CursedPrograms/WHIP-Robot-v00/images/whip_real_round.png

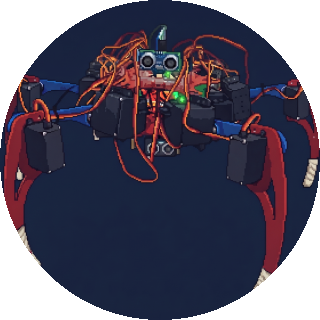
images/whip_real_round.png
