CursedPrograms/WHIP-Robot-v00/6 legged spider robot assembly manual.pdf

# 6 Assembly Instructions for the Spider Robot

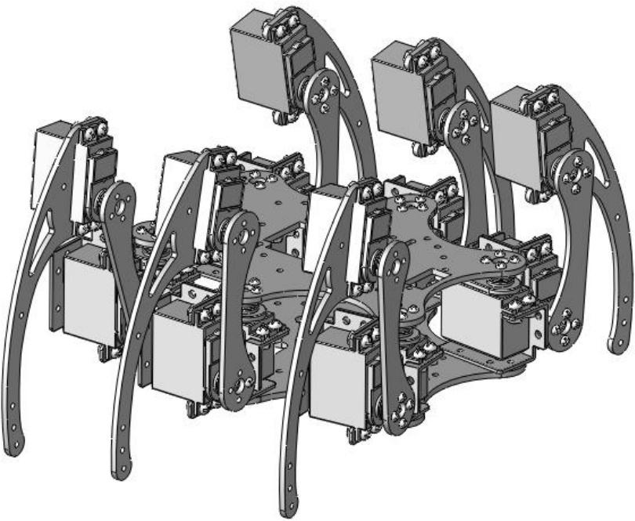
[picture p16: figure]

Preface

1.Installation Tools
Before installing the robot, it is necessary to prepare the necessary installation tools, including a crosshead screwdriver, a pair of pointed pliers, and a pair of forceps. Users with the conditions can prepare an electric screwdriver, which is both convenient and efficient, as shown in the reference image below.

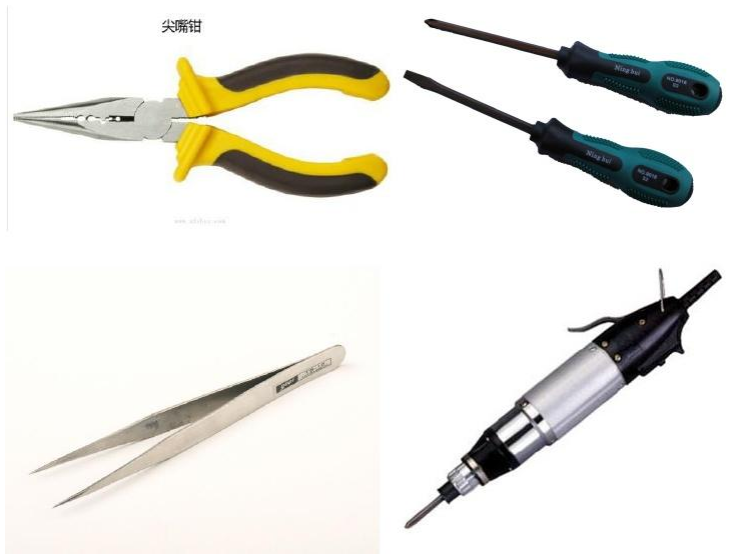
[picture p17: figure]

2. Usage Precautions
(1) There is a large enough platform space for the
installation of robots;
(2) During the operation, prevent mechanical damage and keep away from infants and young children. If left unattended, improper operation may cause harm to people. (3) The wiring and debugging of electronic accessories require

personnel with certain electronic knowledge and foundation to operate. It is prohibited to connect the wires without understanding the situation, as it is prone to causing short circuits or burns of the accessories. (4) Disassembling the battery is prohibited. When the robot

malfunctions, please cut off the power supply in time. battery

During use, recharge frequently and avoid excessive discharging. Do not short-circuit the positive and negative electrodes of the battery. The consequence of short-circuiting is very serious. Do not allow young children to charge, discharge or use the battery alone

(5) During the use of the robot, be careful to handle it gently and avoid throwing or hitting it. Also, take measures to prevent the robot from frequently falling, as this can easily cause structural deformation of the robot, thereby leading to abnormal operation.
I. Connection and Installation between Metal Structural Components
1. Installation of the right leg joint bracket
Quantity: Install 3 sets
Requirement: Install vertically without tilt. Accessories: Round head M3*6 screws, M3 nuts

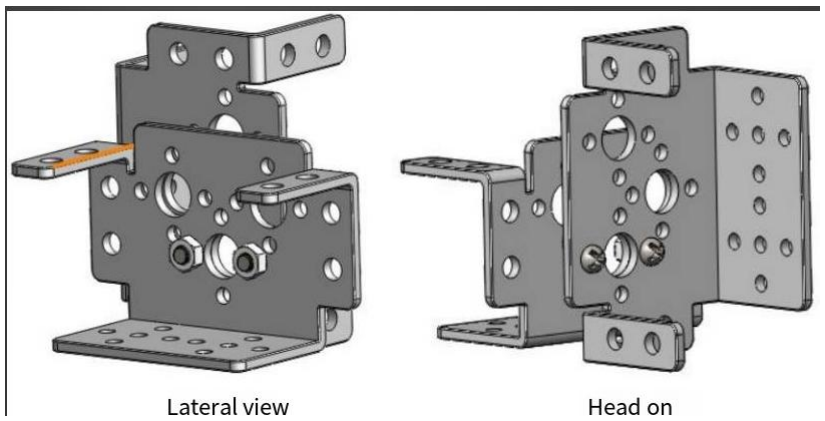
[picture p18: figure]

2. Installation of the left leg joint bracket Quantity: Install 3 sets
Requirement: Install vertically without tilt. Accessories: Round head M3*7 screws, M3 nut

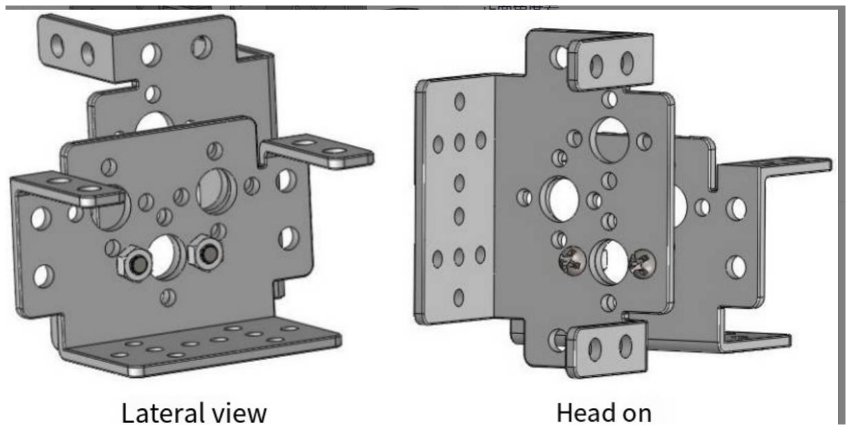
[picture p19: figure]

### II. Installation and Fixation of Each Component's Steering Gear

All the steering gear angles should be adjusted to the median position of 1500. The steering gear should be installed vertically and horizontally when installing the steering wheel. 1. Installation and fixation of the right calf bracket and

steering gear
Quantity: Install 3 sets
Requirement: Install vertically without tilt. Accessories: Round head M4*8 screws, M4 nuts

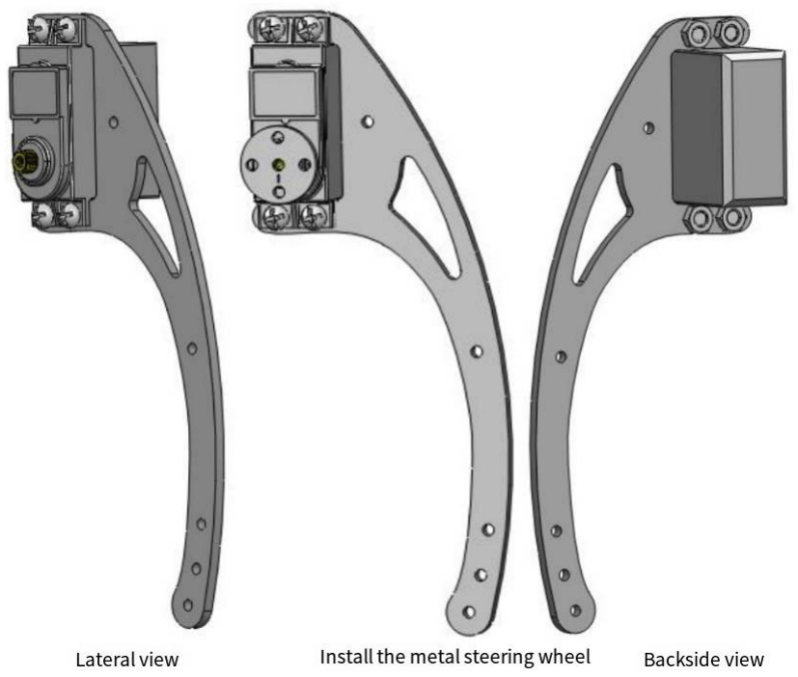
[picture p20: figure]

2. Installation and fixation of the left calf bracket and steering gear
Quantity: Install 3 sets
Requirement: Install vertically without tilt. Accessories: Round head M4*8 screws, M4 nuts

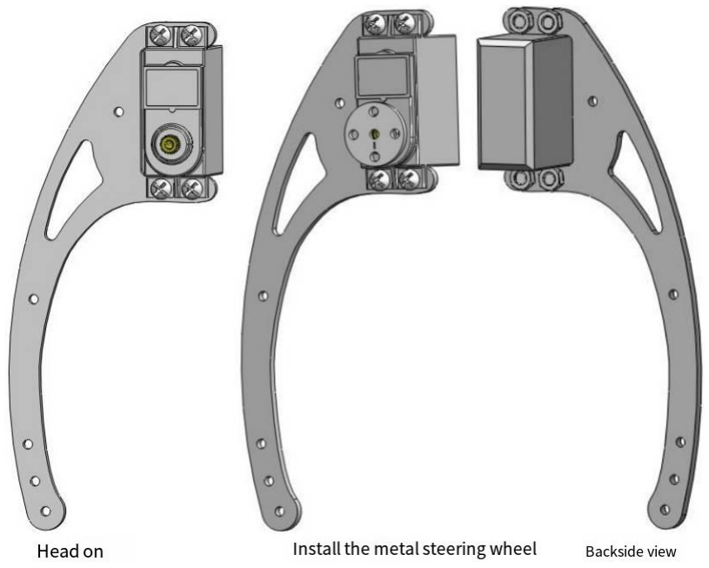
[picture p21: figure]

3. Installation and fixation of the right thigh joint bracket and steering gear
Quantity: Install 3 sets
Requirement: Vertical installation, no tilt. Accessories: Round head M4*8 screws, M4 nuts

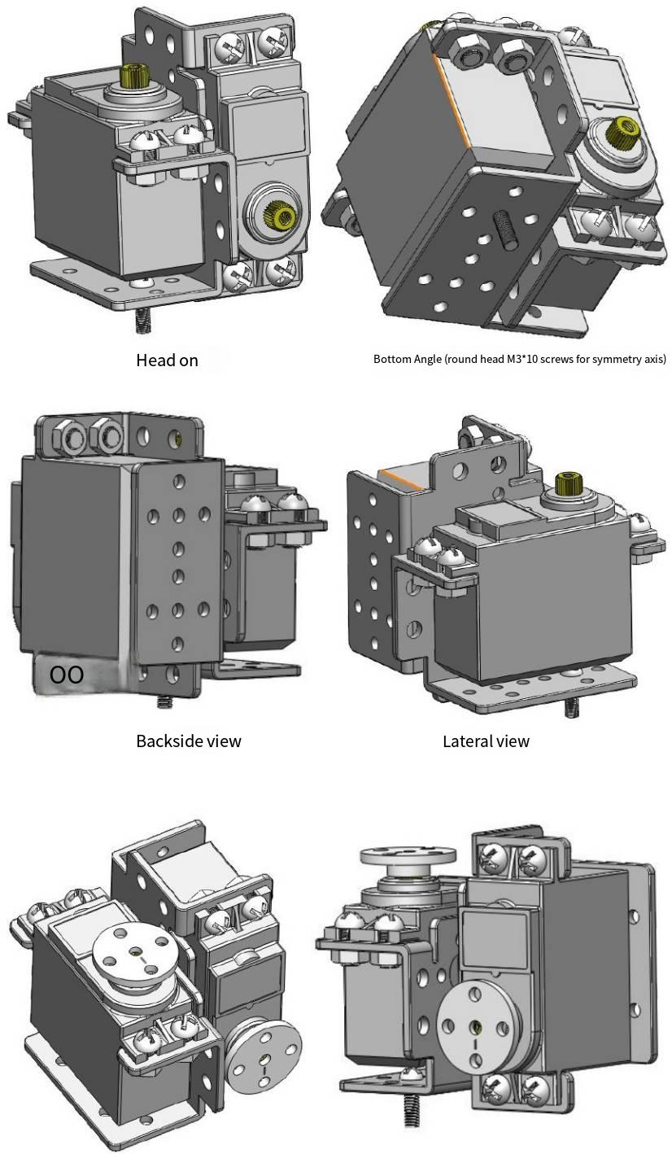
[picture p22: figure]
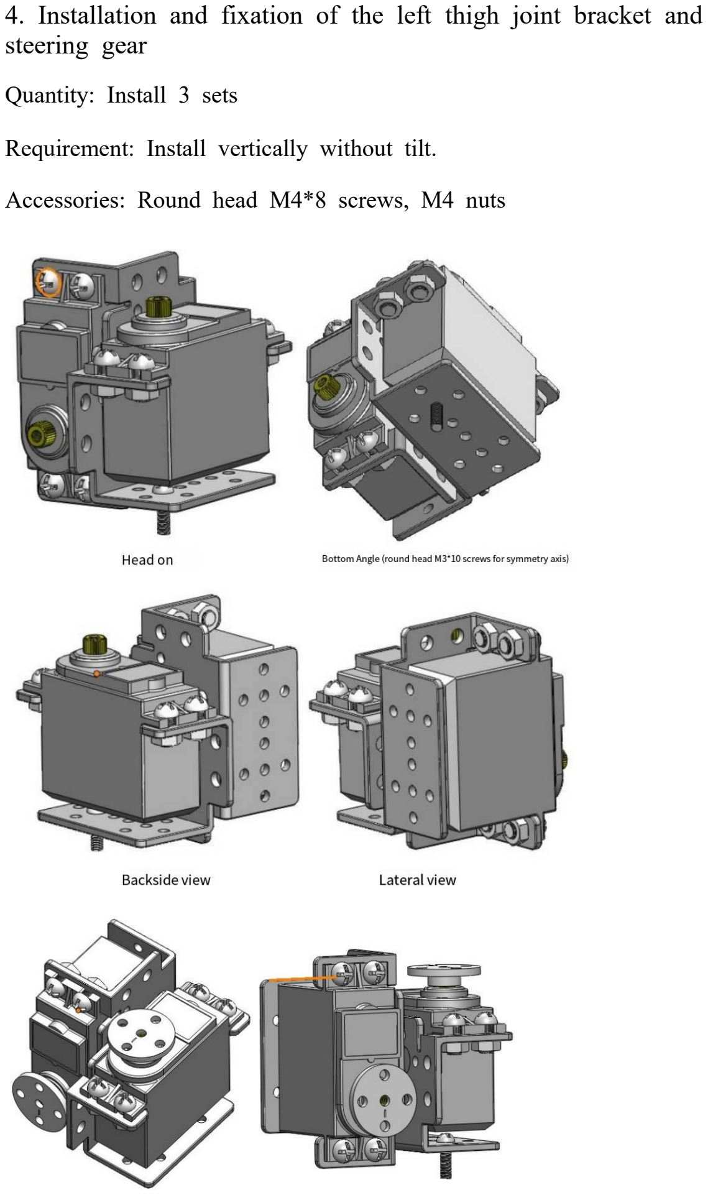
[picture p23: page 8]

4. Installation and fixation of the left thigh joint bracket and steering gear
Quantity: Install 3 sets
Requirement: Install vertically without tilt. Accessories: Round head M4*8 screws, M4 nuts

### III. Splicing and Installation of Each Component

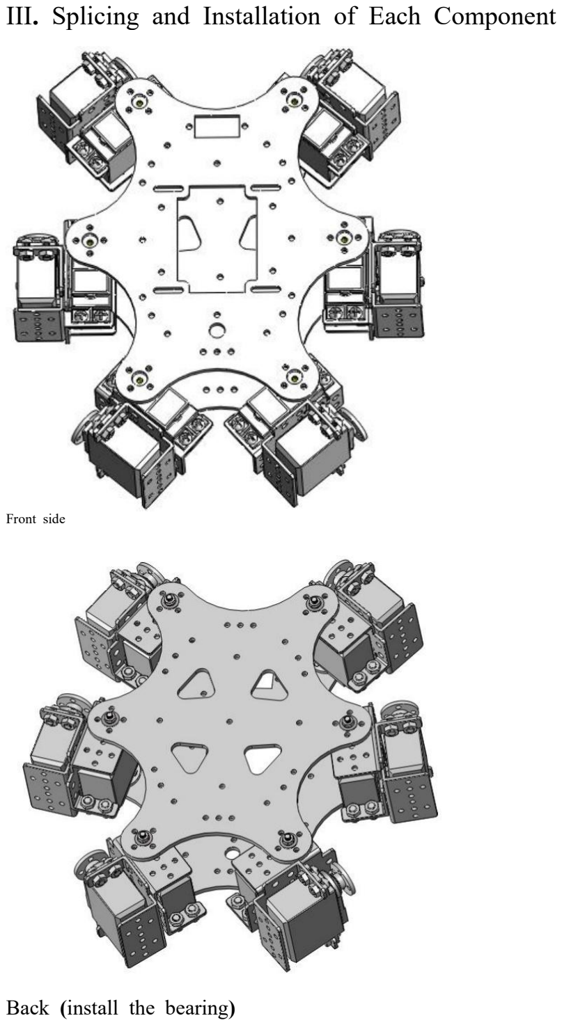
[picture p24: page 9]

Front side

Back (install the bearing)

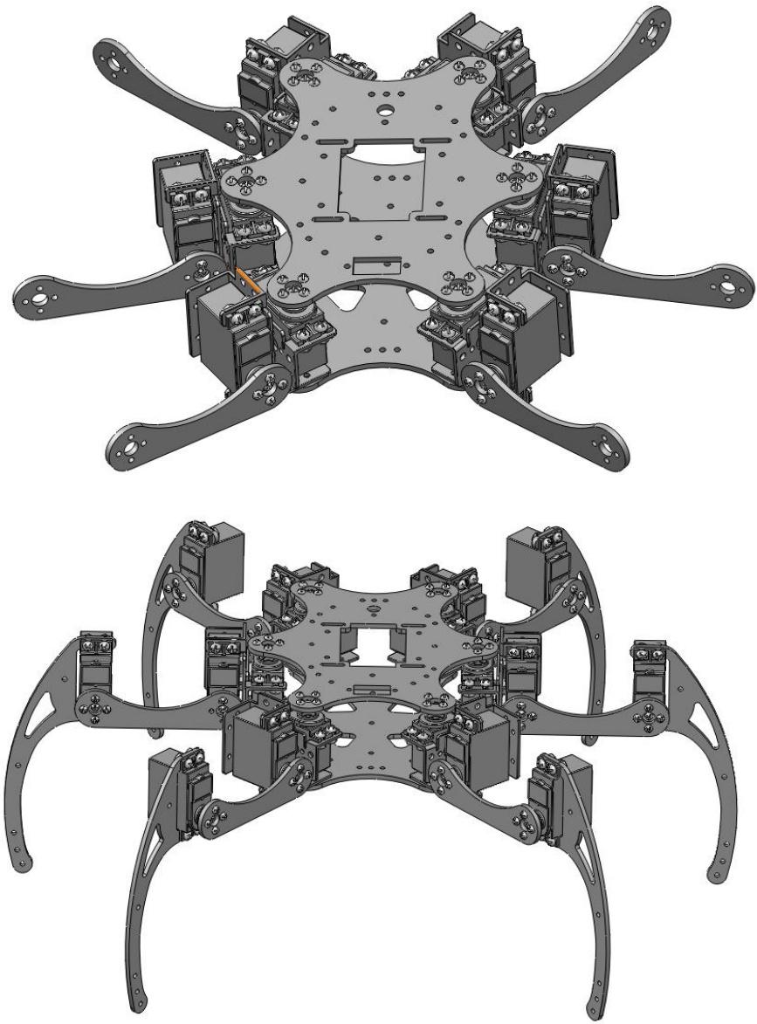
[picture p25: figure]
