CursedPrograms/WHIP-Robot-v00/scripts/keymap.py

#!/usr/bin/env python3
"""keymap.py - every key, gamepad button and remote button WHIP takes, in its own window.

    python scripts/keymap.py                  opens the window (the controller opens it with F1)
    python scripts/keymap.py --header FILE.h  writes the web page's /keys page (a PROGMEM string)
    python scripts/keymap.py --readme README.md   rewrites the README's "Controls" tables
    python scripts/keymap.py --markdown       prints those tables

The one list of the robot's controls. After changing it, write the header (and reflash) and
the README again, so all of them say the same.
"""

TITLE = "WHIP - controls"

KEYMAP = [
    ("Controller: keyboard", [
        ("W / Up", "walk forward (hold)"),
        ("S / Down", "walk back (hold)"),
        ("A / Left, D / Right", "turn left / right (hold)"),
        ("1", "the controller drives (web mode)"),
        ("2", "obstacle avoidance: he walks by himself"),
        ("3", "IR-remote mode"),
        ("V", "stop: he stands, in any mode (switches to web mode)"),
        ("M", "MIND mode on / off: the LLM on this PC drives him (x86 PC, GTX 1050+)"),
        ("G", "next gait: tripod, ripple, wave, quad, amble, metachronal (gaits firmware; or the Gait dropdown)"),
        ("Z / X / C", "tripod / ripple / wave"),
        ("T", "tilt safety on / off (on again at every boot)"),
        ("B", "buzzer on / off"),
        ("Q / E", "crab left / right (hold; gaits firmware)"),
        ("F", "follow-me mode: he keeps your hand 30 cm from his sonar"),
        ("H / N", "wave hello / a little dance"),
        ("R", "lie down / get up (he lies down by himself after a minute standing still)"),
        ("Mouse", "every function is a button: the strip along the top (modes, STOP, CENTER, HELLO, DANCE, REST, EMULATE), the pad's buttons, and the D-pad (hold)"),
        ("CENTER", "stop, every servo to its middle (1500 us + its trim); again: stand up"),
        ("BODY", "body IK: his body slides and tilts over planted feet. Sticks; or W/S A/D slide, R/F up / down, Q/E twist, I/K pitch, J/L roll"),
        ("EMULATE", "a pretend WHIP on this PC, to try the controller with no robot (scripts/fake_whip.py)"),
        ("F1", "this window"),
        ("F5", "record a macro; again to save it (scripts/macros/)"),
        ("F6", "play or stop the chosen macro"),
        ("F7", "choose the next macro"),
        ("Esc", "quit"),
    ]),
    ("Controller: gamepad or joystick (ARM's flight stick works too)", [
        ("Left stick / D-pad", "walk forward / back, turn left / right (the stick with speed, gaits firmware)"),
        ("Right stick", "crab left / right (gamepads; gaits firmware)"),
        ("Cross / A (0)", "the controller drives (web mode)"),
        ("Circle / B (1)", "obstacle avoidance"),
        ("Square / X (2)", "IR-remote mode"),
        ("Triangle / Y (3)", "stop"),
        ("Start (11)", "MIND mode on / off"),
        ("L1 / R1 (4 / 5)", "previous / next gait"),
        ("Select (8)", "tilt safety on / off"),
        ("L2 / R2 (6 / 7)", "wave hello / dance"),
        ("", "plug it in any time"),
    ]),
    ("PS2 pad on WHIP himself (its receiver on GPIO 25 / 26 / 27 / 32, 3.3 V; gaits firmware)", [
        ("Left stick / D-pad", "walk and turn, with speed (takes over: WEB mode; let go and he stands)"),
        ("Right stick", "crab left / right"),
        ("Cross / Triangle", "stand (web mode)"),
        ("Circle", "obstacle avoidance"),
        ("Square", "follow-me mode"),
        ("L1 / R1", "previous / next gait"),
        ("L2 / R2", "wave hello / dance"),
        ("Start", "lie down / get up"),
        ("Select", "tilt safety on / off"),
        ("L3", "buzzer on / off"),
        ("R3 (right stick click)", "BODY mode on / off: left stick slides his body, right stick tilts it, L1 / R1 twist, D-pad up / down raise / lower; feet stay planted"),
    ]),
    ("His IR remote", [
        ("1", "IR-remote mode (he boots in obstacle avoidance: press this first)"),
        ("2", "obstacle avoidance"),
        ("Up / Down", "walk forward / back (hold)"),
        ("Left / Right", "turn left / right (hold)"),
        ("OK", "stop"),
        ("3 / 4 / 5", "next gait / wave hello / dance (gaits firmware)"),
        ("6 / 7", "follow-me mode / lie down, get up"),
        ("", "NORA's remote sends other codes: it can't drive him"),
    ]),
    ("NORA's IR link (her web page, controller or Bluetooth)", [
        ("arrows / I J K L", "walk / turn"),
        ("STOP", "stop"),
        ("AUTO / MANUAL", "obstacle avoidance / IR-remote mode"),
        ("LOCK / UNLOCK", "lock his legs (he stands, walks for nobody) / free them"),
        ("", "the same lock over WiFi: /motorlockOn, /motorlockOff?pw=<his PIN> (RIFT's Lock all / Unlock all)"),
    ]),
    ("Web page (:5005)", [
        ("PIN, then the D-pad", "unlock with the PIN, then walk (hold)"),
        ("Mode buttons", "obstacle / IR / web, and MIND while his PC controller can think"),
        ("Gait dropdown, G, 1-6", "tripod / ripple / wave / quad / amble / metachronal, with a little animation of the one picked"),
        ("TILT, T", "tilt safety on / off"),
        ("SOUND, B", "buzzer on / off"),
        ("FOLLOW, F", "follow-me mode"),
        ("HELLO / DANCE / REST, H / N / R", "wave hello, dance, lie down / get up"),
        ("Crab buttons", "the D-pad's bottom corners: sideways left / right"),
        ("KEYS", "this list"),
        ("/calib", "line the legs up (stand, trims, height, speed)"),
    ]),
    ("Debug console (Serial2, GPIO17, 115200)", [
        ("x", "shut down: settle into the lowest stance"),
    ]),
]


# ── Everything below is the same in every robot's keymap.py ─────────────────────

def show(title=None, keymap=None):
    """The keymap in its own small window: one table per input, scrolls if it's long."""
    import tkinter as tk

    title, keymap = title or TITLE, keymap or KEYMAP
    bg, panel, accent, text, dim = "#07090f", "#0a0e1a", "#6496e6", "#d7e6ff", "#4a5f80"
    root = tk.Tk()
    root.title(title)
    root.configure(bg=bg)
    root.geometry("560x720")
    canvas = tk.Canvas(root, bg=bg, highlightthickness=0)
    bar = tk.Scrollbar(root, command=canvas.yview)
    body = tk.Frame(canvas, bg=bg)
    body.bind("<Configure>", lambda e: canvas.configure(scrollregion=canvas.bbox("all")))
    canvas.create_window((0, 0), window=body, anchor="nw")
    canvas.configure(yscrollcommand=bar.set)
    canvas.pack(side="left", fill="both", expand=True)
    bar.pack(side="right", fill="y")
    canvas.bind_all("<MouseWheel>", lambda e: canvas.yview_scroll(-1 if e.delta > 0 else 1, "units"))
    canvas.bind_all("<Button-4>", lambda e: canvas.yview_scroll(-1, "units"))
    canvas.bind_all("<Button-5>", lambda e: canvas.yview_scroll(1, "units"))

    tk.Label(body, text=title.upper(), bg=bg, fg=accent,
             font=("Courier New", 16, "bold")).pack(anchor="w", padx=16, pady=(14, 4))
    for section, rows in keymap:
        tk.Label(body, text=section, bg=bg, fg=accent,
                 font=("Courier New", 12, "bold")).pack(anchor="w", padx=16, pady=(12, 4))
        table = tk.Frame(body, bg=panel)
        table.pack(fill="x", padx=16)
        for i, (key, does) in enumerate(rows):
            tk.Label(table, text=key, bg=panel, fg=text, font=("Courier New", 11, "bold"),
                     anchor="w", width=18).grid(row=i, column=0, sticky="w", padx=(8, 4), pady=1)
            tk.Label(table, text=does, bg=panel, fg=text if key else dim, font=("Courier New", 10),
                     anchor="w", justify="left", wraplength=330).grid(row=i, column=1, sticky="w", pady=1)
    root.bind("<Escape>", lambda e: root.destroy())
    root.bind("<F1>", lambda e: root.destroy())
    root.mainloop()


def to_markdown(keymap=None):
    """The README's "Controls" tables."""
    out = []
    for section, rows in keymap or KEYMAP:
        out += [f"**{section}**", "", "| Key | Does |", "|---|---|"]
        for key, does in rows:
            out.append(f"| {key} | {does} |" if key else f"| | *{does}* |")
        out.append("")
    return "\n".join(out)


def to_html(title=None, keymap=None):
    """The /keys page: the same tables, for the robot's own web page."""
    from html import escape
    title = title or TITLE
    rows = []
    for section, items in keymap or KEYMAP:
        rows.append(f"<h2>{escape(section)}</h2><table>")
        for key, does in items:
            rows.append(f"<tr><th>{escape(key)}</th><td>{escape(does)}</td></tr>" if key
                        else f"<tr><td colspan=2 class=n>{escape(does)}</td></tr>")
        rows.append("</table>")
    return ("<!DOCTYPE html><html><head><meta charset=utf-8>"
            "<meta name=viewport content='width=device-width,initial-scale=1'>"
            f"<title>{escape(title)}</title><style>"
            "body{background:#07090f;color:#d7e6ff;font-family:'Courier New',monospace;margin:0;padding:16px}"
            "h1{color:#6496e6;font-size:1.3rem;letter-spacing:2px}h2{color:#6496e6;font-size:1rem;margin:18px 0 6px}"
            "table{width:100%;border-collapse:collapse;background:#0a0e1a}"
            "th,td{text-align:left;padding:4px 8px;border-bottom:1px solid #1e3458;vertical-align:top}"
            "th{white-space:nowrap;width:1%}.n{color:#4a5f80;font-style:italic}"
            f"</style></head><body><h1>{escape(title.upper())}</h1>{''.join(rows)}</body></html>")


def write_header(path, name="KEYS_HTML"):
    """The /keys page as a C header for the ESP sketch. Generated: edit keymap.py, not the header."""
    import os
    with open(path, "w", encoding="utf-8", newline="\n") as f:
        f.write(f"// {os.path.basename(path)} - generated by keymap.py (python keymap.py --header ...).\n"
                "// Don't edit it: change the list in keymap.py and write it again.\n"
                "#pragma once\n"
                f'static const char {name}[] PROGMEM = R"keys(' + to_html() + ')keys";\n')


def write_readme(path, start="<!-- keymap:start -->", end="<!-- keymap:end -->"):
    """Put the tables in the README between the two markers (added under "Controls" the first time)."""
    with open(path, encoding="utf-8") as f:
        text = f.read()
    block = f"{start}\n<!-- generated by keymap.py --readme; edit the list there -->\n\n{to_markdown()}\n{end}"
    if start in text and end in text:
        text = text[:text.index(start)] + block + text[text.index(end) + len(end):]
    else:
        raise SystemExit(f"{path}: put {start} and {end} where the tables go")
    with open(path, "w", encoding="utf-8", newline="") as f:
        f.write(text)


def open_window():
    """Open the keymap window without blocking the caller (its own process, so pygame keeps running)."""
    import os
    import subprocess
    import sys
    try:
        subprocess.Popen([sys.executable, os.path.abspath(__file__)])
    except OSError as e:
        print(f"[keymap] can't open the window: {e}")


if __name__ == "__main__":
    import sys
    if "--header" in sys.argv:
        write_header(sys.argv[sys.argv.index("--header") + 1])
    elif "--readme" in sys.argv:
        write_readme(sys.argv[sys.argv.index("--readme") + 1])
    elif "--markdown" in sys.argv:
        print(to_markdown())
    else:
        show()
