CursedPrograms/WHIP-Robot-v00/scripts/esp32_gaits/leds.h

/*
  leds.h - WHIP's 4x4 RGB LED grid (16 WS2812 / NeoPixel, Adafruit_NeoPixel).

  Wiring: DIN -> GPIO18 (through a ~330 ohm resistor if you have one), 5V -> the
  ESP32's 5 V, GND -> GND (shared with the ESP32). Not the 6 V servo rail: it's
  over the LEDs' 5.3 V limit. A 3.3 V data line drives them fine nearly always;
  if they flicker, power the grid at 4.5-5 V or add a level shifter.

  The grid is WHIP seen from above, head at the top:

      LF   eye  eye   RF       legs: dim on the ground, bright while that foot is in the air
      LM   mode mode  RM             (his gait, live, as he walks)
      LM   mode mode  RM       mode: obstacle blue, IR violet, web green, MIND pink, follow teal
      LB   tail tail  RB       eyes: red when there's a wall; tail: orange while tilt safety is off

  Tilt stop: the whole grid flashes orange. Legs locked: everything dim red. Lying down:
  his mode colour, very dim and slow. Picked up: violet flicker. Dancing: colours.
  Starting (the 5 s after power-on before he walks off): red, filling row by row. BODY mode: amber.
  Legs: in his gait's colour (tripod red, ripple orange, wave yellow, quad green, amble cyan,
  metachronal magenta), dim on the ground, bright while that foot is in the air.

  Every look's colour and effect (solid / breathe / blink / rainbow / off) and the brightness are
  his to change: the /lights page (colour pickers), /leds?look=web&rgb=ff0000&fx=1 or ?bright=40,
  kept in flash (Preferences "whip_leds"); /leds?reset=1 puts the colours above back.
  If the picture comes out turned or mirrored, set GRID_ROTATE / GRID_MIRROR;
  if every other row is backwards, the grid is wired zig-zag: GRID_SERPENTINE.
  Brightness stays low (GRID_BRIGHTNESS): 16 LEDs at full white pull ~1 A.
*/
#pragma once
#include <Adafruit_NeoPixel.h>
#include <Preferences.h>
#include "gaits.h"

namespace leds {

const int     PIN             = 18;
const uint8_t SIDE            = 4;
const uint8_t COUNT           = SIDE * SIDE;
const uint8_t GRID_BRIGHTNESS = 40;     // of 255
const uint8_t GRID_ROTATE     = 0;      // quarter turns clockwise, 0-3: where LED 0 sits vs his head
const bool    GRID_MIRROR     = false;  // left and right swapped
const bool    GRID_SERPENTINE = false;  // rows wired zig-zag (every other row runs backwards)

enum Look : uint8_t { OBSTACLE, IR, WEB, MIND, FOLLOW, LOCKED, TILT_STOP, HELD, SHUTDOWN, STARTING, BODY,
                      GAIT_LOOK, LOOKS = GAIT_LOOK + 6 };   // GAIT_LOOK + n: the legs' colour in gait n
const char* const LOOK_NAMES[LOOKS] = { "obstacle", "ir", "web", "mind", "follow", "locked", "tilt", "held",
                                        "shutdown", "starting", "body",
                                        "tripod", "ripple", "wave", "quad", "amble", "metachronal" };
enum Fx : uint8_t { FX_SOLID, FX_BREATHE, FX_BLINK, FX_RAINBOW, FX_OFF, FXS };
const char* const FX_NAMES[FXS] = { "solid", "breathe", "blink", "rainbow", "off" };

struct LookCfg { uint8_t r, g, b, fx; };
const LookCfg DEFAULT_CFG[LOOKS] = {
  { 26, 123, 217, FX_BREATHE },   // obstacle: his second colour, blue
  { 150, 80, 230, FX_BREATHE },   // ir: violet
  { 211, 72, 89, FX_BREATHE },    // web: his red
  { 230, 80, 180, FX_BREATHE },   // mind: pink
  { 0, 200, 190, FX_BREATHE },    // follow: teal
  { 200, 64, 64, FX_SOLID },      // locked: dim red
  { 255, 150, 0, FX_BLINK },      // tilt stop: orange flashes
  { 170, 60, 255, FX_BLINK },     // held (picked up): violet flicker
  { 0, 0, 0, FX_OFF },            // shutdown
  { 255, 0, 0, FX_SOLID },        // starting: red, filling up as the 5 s run out
  { 255, 170, 0, FX_BREATHE },    // body mode: amber
  { 255, 40, 50, FX_SOLID },      // gaits (the legs): tripod red
  { 255, 120, 0, FX_SOLID },      //   ripple orange
  { 255, 220, 0, FX_SOLID },      //   wave yellow
  { 40, 230, 60, FX_SOLID },      //   quad green
  { 0, 200, 255, FX_SOLID },      //   amble cyan
  { 230, 40, 255, FX_SOLID },     //   metachronal magenta
};
LookCfg cfg[LOOKS];
uint8_t brightness = 40;
Preferences store;

inline void load() {
  memcpy(cfg, DEFAULT_CFG, sizeof(cfg));
  store.begin("whip_leds", true);
  if (store.getBytesLength("cfg") == sizeof(cfg)) store.getBytes("cfg", cfg, sizeof(cfg));
  brightness = store.getUChar("bright", 40);
  store.end();
}

inline void save() {
  store.begin("whip_leds", false);
  store.putBytes("cfg", cfg, sizeof(cfg));
  store.putUChar("bright", brightness);
  store.end();
}

struct State {
  Look look;
  bool walking;          // a gait is running: show the feet
  const ik::Gait* gait;  // ...this one
  bool wall;             // something too close ahead
  bool tiltOff;          // tilt safety switched off
  bool resting;          // lying down
  bool dancing;
  float startFrac = 0;   // STARTING: how much of the 5 s has gone (0..1)
  uint8_t gaitId = 0;    // the chosen gait: the legs' colour
  char talkSym = 0;      // the Brainfuck symbol he's beeping now: the whole grid shows it
};

// Which leg each cell shows (row 0 = his head), or -1 for the middle
const int8_t CELL_LEG[SIDE][SIDE] = {
  { ik::LF, -1, -1, ik::RF },
  { ik::LM, -1, -1, ik::RM },
  { ik::LM, -1, -1, ik::RM },
  { ik::LB, -1, -1, ik::RB },
};

Adafruit_NeoPixel px(COUNT, PIN, NEO_GRB + NEO_KHZ800);
unsigned long lastShow = 0;

inline void begin() {
  load();
  px.begin();
  px.setBrightness(brightness);
  px.clear();
  px.show();
}

// The LED number for the cell at (row, col) of the picture above
inline uint8_t index(uint8_t row, uint8_t col) {
  if (GRID_MIRROR) col = SIDE - 1 - col;
  for (uint8_t q = 0; q < GRID_ROTATE % 4; q++) {   // a quarter turn clockwise
    const uint8_t r = row;
    row = col;
    col = SIDE - 1 - r;
  }
  if (GRID_SERPENTINE && (row & 1)) col = SIDE - 1 - col;
  return row * SIDE + col;
}

inline uint32_t scaled(uint8_t r, uint8_t g, uint8_t b, float k) {
  return Adafruit_NeoPixel::Color((uint8_t)(r * k), (uint8_t)(g * k), (uint8_t)(b * k));
}

inline void lookColour(Look l, uint8_t& r, uint8_t& g, uint8_t& b) {
  const LookCfg& c = cfg[l < LOOKS ? l : LOCKED];
  r = c.r; g = c.g; b = c.b;
}

// How bright this look's effect is now (0..1); FX_RAINBOW is drawn on its own
inline float fxLevel(uint8_t fx, unsigned long now) {
  switch (fx) {
    case FX_SOLID:   return 0.6f;
    case FX_BLINK:   return (now / 250) % 2 ? 1.0f : 0.0f;
    case FX_OFF:     return 0.0f;
    default:         return 0.35f + 0.25f * sinf(now / 600.0f);   // breathe
  }
}

// Call often (every loop and every wait): redraws at ~30 fps, cheap otherwise.
// force: draw now (before he stops calling it, as at shutdown).
inline void update(const State& s, bool force = false) {
  const unsigned long now = millis();
  if (!force && now - lastShow < 33) return;
  lastShow = now;

  px.setBrightness(brightness);
  if (s.talkSym) {   // talking: a colour for each symbol, '.' (a letter landing) white
    uint32_t c;
    switch (s.talkSym) {
      case '+': c = px.Color(0, 200, 60); break;
      case '-': c = px.Color(200, 20, 20); break;
      case '>': c = px.Color(20, 90, 220); break;
      case '<': c = px.Color(140, 40, 220); break;
      case '[': case ']': c = px.Color(220, 150, 0); break;
      default:  c = px.Color(255, 255, 255); break;
    }
    px.fill(c);
    px.show();
    return;
  }
  const LookCfg& lc = cfg[s.look < LOOKS ? s.look : LOCKED];
  if (s.look == SHUTDOWN || lc.fx == FX_OFF) { px.clear(); px.show(); return; }
  if (lc.fx == FX_RAINBOW) {   // this look, as a rainbow running round the grid
    for (uint8_t i = 0; i < COUNT; i++) px.setPixelColor(i, px.ColorHSV((uint16_t)(now * 40 + i * 4096)));
    px.show();
    return;
  }
  if (s.look == STARTING) {    // the 5 s before he walks off: filling up row by row from his tail
    const float rows = s.startFrac * SIDE;
    for (uint8_t row = 0; row < SIDE; row++)
      for (uint8_t col = 0; col < SIDE; col++) {
        const float lit = constrain(rows - (SIDE - 1 - row), 0.0f, 1.0f);
        px.setPixelColor(index(row, col), scaled(lc.r, lc.g, lc.b, 0.08f + 0.92f * lit * fxLevel(lc.fx, now) / 0.6f));
      }
    px.show();
    return;
  }
  if (s.look == TILT_STOP) {
    const uint32_t c = scaled(lc.r, lc.g, lc.b, fxLevel(lc.fx, now));
    for (uint8_t i = 0; i < COUNT; i++) px.setPixelColor(i, c);
    px.show();
    return;
  }

  if (s.look == HELD) {   // picked up: a flicker
    for (uint8_t i = 0; i < COUNT; i++) px.setPixelColor(i, scaled(lc.r, lc.g, lc.b, (now / 90 + i) % 3 ? 0.25f : 1.0f));
    px.show();
    return;
  }
  if (s.dancing) {        // a rainbow running round the grid
    for (uint8_t i = 0; i < COUNT; i++) px.setPixelColor(i, px.ColorHSV((uint16_t)(now * 40 + i * 4096)));
    px.show();
    return;
  }

  uint8_t r, g, b;
  lookColour(s.look, r, g, b);
  float breathe = s.look == LOCKED ? 0.15f : fxLevel(lc.fx, now);
  if (s.resting) breathe = 0.04f + 0.04f * sinf(now / 1500.0f);

  for (uint8_t row = 0; row < SIDE; row++) {
    for (uint8_t col = 0; col < SIDE; col++) {
      const int8_t leg = CELL_LEG[row][col];
      uint32_t c = scaled(r, g, b, breathe);

      if (leg >= 0) {   // the legs: his gait's colour
        const LookCfg& gc = cfg[GAIT_LOOK + (s.gaitId < 6 ? s.gaitId : 0)];
        c = scaled(gc.r, gc.g, gc.b, s.walking ? 0.12f : breathe * 0.6f);
        if (s.walking && s.gait && s.gait->air[leg]) {   // that foot is up: brighter, whiter the higher
          const float lift = constrain((s.gait->foot[leg].z - ik::homeZ()) / ik::LIFT, 0.0f, 1.0f);
          const float k = 0.15f + 0.45f * lift;
          c = Adafruit_NeoPixel::Color(gc.r + (uint8_t)((255 - gc.r) * k), gc.g + (uint8_t)((255 - gc.g) * k),
                                       gc.b + (uint8_t)((255 - gc.b) * k));
        }
      } else if (row == 0 && s.wall) {
        c = scaled(255, 0, 0, (now / 150) % 2 ? 1.0f : 0.4f);
      } else if (row == SIDE - 1 && s.tiltOff) {
        c = scaled(255, 150, 0, 0.8f);
      }
      px.setPixelColor(index(row, col), c);
    }
  }
  px.show();
}

}  // namespace leds
