CursedPrograms/WHIP-Robot-v00/scripts/esp32/avatar.h

// WHIP's avatar (images/whip_avatar.jpg, 160x160 JPEG) for the web page and favicon.
// Generated from the image -- regenerate it rather than editing by hand.
#pragma once
#include <pgmspace.h>

static const uint8_t AVATAR_JPG[] PROGMEM = {
  0xFF, 0xD8, 0xFF, 0xE0, 0x00, 0x10, 0x4A, 0x46, 0x49, 0x46, 0x00, 0x01, 0x01, 0x00, 0x00, 0x01,
  0x00, 0x01, 0x00, 0x00, 0xFF, 0xDB, 0x00, 0x43, 0x00, 0x06, 0x04, 0x04, 0x05, 0x04, 0x04, 0x06,
  0x05, 0x05, 0x05, 0x06, 0x06, 0x06, 0x07, 0x09, 0x0E, 0x09, 0x09, 0x08, 0x08, 0x09, 0x12, 0x0D,
  0x0D, 0x0A, 0x0E, 0x15, 0x12, 0x16, 0x16, 0x15, 0x12, 0x14, 0x14, 0x17, 0x1A, 0x21, 0x1C, 0x17,
  0x18, 0x1F, 0x19, 0x14, 0x14, 0x1D, 0x27, 0x1D, 0x1F, 0x22, 0x23, 0x25, 0x25, 0x25, 0x16, 0x1C,
  0x29, 0x2C, 0x28, 0x24, 0x2B, 0x21, 0x24, 0x25, 0x24, 0xFF, 0xDB, 0x00, 0x43, 0x01, 0x06, 0x06,
  0x06, 0x09, 0x08, 0x09, 0x11, 0x09, 0x09, 0x11, 0x24, 0x18, 0x14, 0x18, 0x24, 0x24, 0x24, 0x24,
  0x24, 0x24, 0x24, 0x24, 0x24, 0x24, 0x24, 0x24, 0x24, 0x24, 0x24, 0x24, 0x24, 0x24, 0x24, 0x24,
  0x24, 0x24, 0x24, 0x24, 0x24, 0x24, 0x24, 0x24, 0x24, 0x24, 0x24, 0x24, 0x24, 0x24, 0x24, 0x24,
  0x24, 0x24, 0x24, 0x24, 0x24, 0x24, 0x24, 0x24, 0x24, 0x24, 0x24, 0x24, 0x24, 0x24, 0xFF, 0xC0,
  0x00, 0x11, 0x08, 0x00, 0xA0, 0x00, 0xA0, 0x03, 0x01, 0x22, 0x00, 0x02, 0x11, 0x01, 0x03, 0x11,
  0x01, 0xFF, 0xC4, 0x00, 0x1C, 0x00, 0x00, 0x02, 0x02, 0x03, 0x01, 0x01, 0x00, 0x00, 0x00, 0x00,
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
  0x02, 0x4F, 0x63, 0x5F, 0x55, 0xEB, 0xBA, 0x27, 0x43, 0x41, 0x67, 0x2D, 0xB6, 0x95, 0x65, 0x1D,
  0xAE, 0xC0, 0x26, 0x8A, 0x78, 0x18, 0x4E, 0x93, 0xB1, 0x18, 0x28, 0x30, 0x17, 0x68, 0xC6, 0x09,
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
};
static const size_t AVATAR_JPG_LEN = sizeof(AVATAR_JPG);
