CursedPrograms/WHIP-Robot-v00/(commit log)

2026-10-04 README for the ESP32 build; requirements; avatar icons
    - Avatar as the site favicon / Apple touch icon, and images/whip.ico for programs
    - GitHub Pages site: CSS and JS split into site/, matching 404.html and 500.html
    - Avatar and controller screenshots in the README and on the site
    - colour_scheme.xml sampled from the avatar
    - README: ESP32 + RTrobot 32-channel controller, pinout, modes, tilt safety, port 5005 (was 5006)
    - requirements.txt was empty: add pygame and requests for scripts/controller.py
    - Python controller: avatar window icon
    - Rename clear-commits scripts; stop ignoring site/ (mkdocs rule)
2026-10-04 Avatar on the ESP32 control page; shrink robot photos
    Serve WHIP's avatar from its own /avatar.jpg route (byte array in
    avatar.h) and use it as the page logo and favicon. Photos resized from
    3060x2916 (13 MB) to 1200x1144 (~2 MB each); site sizes updated.
2026-10-04 Avatar in the Python controller header
    Loaded once through round_avatar(), the one place to swap in an animation later.
    [controller.py]
2026-10-04 Fleet link: NORA can drive WHIP over IR
    Decode Samsung frames too; frames at 0x0DA3 run as the matching remote buttons, with a 600 ms release timeout. README and site document it.
2026-10-04 flash.bat: compile + flash the ESP32, talking you through it
    Same as NORA's: spoken steps, incremental build in build/esp32, no compile when nothing changed.
2026-10-04 Options menu: options.bat edits config.json like a game's options screen
    Shared options.py (same file in every bot): sections as menus, on/off
    toggles, < > number steppers (Shift = 10x), text editing, the bot's own
    colours and avatar; saving keeps config.json.bak.
2026-10-06 WHIP: imposter radar, PIN-1234 lock, fleet proximity, assembly manual
2026-10-14 Walk by inverse kinematics (Jakob Leander's hexapod, same chassis)
    The recorded gait.xml gaits are gone from the firmware: every joint is worked
    out from where each foot should be (scripts/esp32/ik_gait.h), with the leg maths,
    measurements and tripod key frames of https://github.com/JakobLeander/hexapod
    (MIT, notice in the header), 5 interpolation steps per key frame. Direction
    changes always pass through a full stance. Web control, fleet, IR, obstacle
    avoidance and tilt safety are unchanged.
    /calib (PIN): ZERO / HOME / SLEEP, per-servo channel, trim and direction,
    WIGGLE to identify a servo, height and speed, saved in flash. Heights stand him
    higher than the original for his 3S battery; bo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
2026-10-19 Walk in obstacle avoidance 5 s after power-on: WiFi joins in the background, stand at 2 s, gyro while still; keys page (/keys) and window (F1), NORA's leg lock
2026-10-19 MIND mode: his PC controller's LLM drives him (mind.py: look, think, speak in his voice, move, remember)
    - esp32.ino: CTRL_MIND, /mind?act=&steps=, mind host check-in (/unlock&ctl=1, /status?ctl=1), MIND button on his page only while a mind host is there
    - controller.py: unlocks with his PIN (it never did, so every command was LOCKED), M / Start toggles MIND, mind panel with his thoughts
    - mind.py: only on x86 PCs with 8 GB+ RAM and a GTX 1050+ / RX 460+; model sized to the GPU
    - README, page, keymap: he/him, 5 s start, fleet ladder, MIND
2026-10-19 flash.bat sets itself up on a fresh PC: arduino-cli, the ESP32 core (3.3.12) and the libraries
    No Arduino IDE needed: it downloads arduino-cli once, installs esp32:esp32@3.3.12 and the sketch's
    libraries ($Libs) when they're missing, and puts libraries next to the cores when Documents can't be
    written to (Windows Security's controlled folder access). Tested from nothing on Windows 11.
2026-10-19 NIKA joins the fleet: the bottom of the WiFi ladder, the give-way rule (she can't hear ESP-NOW, like MILA), the radar lists, NORA's IR link (0x0DA5), RIFT's port 5013 / relay / personality, the ecosy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
2026-10-20 mind.py: eyes (see(): a vision model describes a camera picture) and each robot's own safety text
2026-10-21 WHIP: servo controller back to 9600 baud
    b718d5b moved the link to 38400, but his RTrobot board is set to 9600 (the
    baud is a setting on the board, the sketch can't change it), so the
    controller ignored every command and nothing moved, not even the stand-up.
    esp32.ino, servo_setup.ino, the README and the page all say 9600 again.
2026-10-21 WiFi leg lock: /motorlockOn, /motorlockOff?pw=
    The same lock as NORA's IR LOCK / UNLOCK (he stands, walks for nobody), now over WiFi, so RIFT's Lock all / Unlock all reaches him and gets an answer. Locking is free, unlocking needs his PIN; /status already says "locked". The keymap, the /keys page and the README list it.
2026-10-24 flash: USB ports only, auto-reset first, remind to unplug the servo controller
2026-10-24 WHIP: 115200 servo link, eased leg moves, smarter avoidance, calmer tilt
    - Servo controller at 115200 (the board is set to it): moves stream back to back.
    - Every leg move eases in and out (smootherstep), ground feet too: no jerk
    at step changes working the legs off their horns.
    - Avoidance turns left and right by turns, looks after every cycle past two,
    stands 0.8 s instead of 3 s; wall at 35 cm, clear at 50 cm.
    - MPU6050 DLPF ~21 Hz, tilt stop at 20 deg / 500 ms (was 10 deg / 250 ms).
2026-10-24 Gaits sketch: tripod / ripple / wave, gait dropdown, LED grid, buzzer
    scripts/esp32_gaits is a copy of the firmware to try new things on
    (flash_gaits.bat, flash.ps1 -Folder):
    - gaits.h: one phase engine for tripod, ripple and wave. Feet on the
    ground slide back together, a swing leaves and lands at the ground's
    speed, landing spots aimed with the speed he'll have, stops by
    stepping home. Gait change mid-walk steps to a stop first.
    - Gait saved in flash; /gait?gait=0-2, /tilt?on=, /buzzer?on=, status
    reports gait, tiltGuard, sound.
    - Wall avoidance looks ahead while turning instead of stopping to check.
    - leds.h: 4x4 WS2812 grid on GPIO18, WHIP from above (legs light up
    in the air,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
2026-10-24 Gaits sketch: analog driving, follow-me, hello, dance, rest, picked-up stop
    - Analog driving: /web?cmd=drive&f=&l=&t= (the controller's sticks: left =
    forward and turn with speed, right = crab), crab buttons / Q E.
    - Follow me (FOLLOW mode, F, IR 6): keeps a hand 30 cm from the sonar.
    - Wave hello and a little dance (/act, H / N, L2 / R2, IR 4 / 5); he
    crouches while NORA has his legs locked.
    - Rest: after a minute standing still he lies down as gait.xml's
    "Reset - Shut Down", gently: belly to the floor on six legs first, then
    one tripod folds, then the other. Any move wakes him in reverse.
    Shutdown ends the same way. REST / R / IR 7 by hand.
    - Picked up: a hard lift / drop or upsi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
2026-10-24 Docs: gaits firmware flashed and walking, build status, LED grid + buzzer
    README and Pages site: IK walking, three gaits, follow / hello / dance /
    rest, picked-up stop, /calib for all 18 servos, RGB grid (GPIO18) and
    buzzer (GPIO19), 115200 servo link, current tilt and obstacle numbers,
    and what's left (Loctite, bearing, grid + buzzer, offsets).
2026-10-24 Controller: buttons for everything, EMULATE, themes, pads; quad gait; XML from his serial
    Controller: a button strip for every function, CENTER (servos to 1500 + trim),
    STOP that stands him in any mode, driving takes over from OBSTACLE / FOLLOW / IR,
    settings re-sent until he confirms (the gait no longer snaps back to tripod),
    SDL gamepad mapping with a raw fallback, mouse D-pad, the gait animation only
    while he walks, DEFAULT / LIGHT / CUSTOM themes from colour_scheme.xml, keys
    1/2/3 modes and Z/X/C gaits, EMULATE (fake_whip.py) to try it with no robot.
    Quad (tetrapod) gait: pairs LB+RM, LM+RF, LF+RB, 2 up 4 down; gait_test passes,
    firmware compiles (not flashed).
    serial_to_xml.py: his se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
2026-10-24 README: his ESP32 board's docs (ACEBOTT QA007 ESP32 Max) and CH340 driver, as NORA's; chassis manual link fixed
2026-10-24 Amble and metachronal gaits; gait_test checks balance; XML redone
    Amble: diagonal pairs LM+RB, LB+RF, LF+RM (none straight across), 4 down.
    Metachronal: one leg at a time round the body, LB LM LF RF RM RB, 5 down.
    gait_test now checks his centre stays >= 40 mm inside the feet that are down
    while he walks (all six: 43-79 mm); pairs straight across, or neighbours one
    after the other, put it on the edge, so those versions were left out. Every
    gait crabs (sidewinding) and turns on the spot (rotational).
    Web page (1-6), controller dropdown, fake WHIP, key list and /keys page know
    all six; gait_emulated.xml redone (38 macros). Firmware compiles, not flashed.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
2026-10-24 PS2 pad on WHIP himself; his voice through the controller
    ps2.h reads a PS2 pad's 9-pin receiver straight off GPIO 27 / 25 / 26 / 32 (DAT /
    CMD / ATT / CLK, an SPI-like protocol, no library), powered from 3.3 V: the pins and
    voltages from his ACEBOTT QA007 board's pin diagram (H1-H12 middle pins are 5 V, so
    not those). The sticks take over (WEB mode) and steer him mid-step through the same
    analog drive the controller uses; buttons as the PC pad's. /status ps2. Compiles,
    not tried on a pad.
    Controller: VOICE (David, theatrical) through this PC outside MIND: connecting,
    modes, gaits, walls, tipping, picked up / put down, rest, CENTER, hello / dance, a
    PS2 pad. controller_kit.py (shared, Voice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
2026-10-24 README: ACEBOTT's Getting started with ESP32 page, with the board's other docs
2026-10-24 README: RTrobot software link (his servo controller's editor, for the gait XML)
2026-10-24 WHIP Servo Studio: sliders, linkages, WHIP himself; groups, XML, the board
    servo_studio.py (servo_studio.bat / .ps1 / .sh): what RTrobot's ServoController
    does, as our own, from its manual and the commands his firmware already speaks.
    ROBOT draws WHIP from above and the side from the pulses (whip_body.py: his IK
    and its exact reverse, round trip 0.000 mm); drag a foot and the IK sets the
    leg. LAYOUT: your own linkage drawing (servo_layout.json). SLIDERS: all 32.
    PIN < > moves a servo to another board pin (swaps, poses follow, saved to
    whip_calibration.json and, over WiFi, on WHIP). Groups: add / insert / update /
    delete / reorder / run / loop, RTrobot XML in and out. Connect: emulate, the
    bo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
2026-10-24 rtrobot_sniff.py: hear what RTrobot's program tells the servo board (TCP relay to its USB port, logged)
    Their settings / Download / Read / Erase commands aren't published; this learns them by
    listening, the way the board hears them, so Servo Studio can send the same.
2026-10-24 gitignore: rtrobot_capture.pcapng (a USB capture of RTrobot's program, read for its board commands)
2026-10-24 Servo types in servo_config.json: the firmware, emulator and studio all follow
    servo_config.json describes each joint's servo (us per degree, middle, limits,
    reach; per joint, and per leg where one differs): MG995 (his, measured), MG996R,
    SG90, DS3218 180 / 270. servo_config.py writes scripts/esp32_gaits/servo_config.h
    (only when it changed); flash.ps1 / flash.sh run it before compiling, and ik_gait.h
    toUs() uses it per joint. whip_body.py and Servo Studio read the JSON; the studio
    picks a type per joint and has APPLY TO FIRMWARE (writes the header, flashes in its
    own window). Defaults unchanged: gait_test passes, gait_emulated.xml byte-identical,
    firmware compiles.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
2026-10-24 Body IK: his body slides and tilts over planted feet (firmware, controller, fake)
    ik_gait.h: bodyFrame() (feet seen from the moved body, R^-1 (f - t)), inReach(),
    fitPose() (scales a pose back until every foot reaches, k = how much fits). gait_test:
    every single-axis limit reaches at heights 0-7, fitPose always lands in reach at 0-9;
    whip_body.py's twin agrees with the C++ to 1e-4.
    Firmware: /body?x=&y=&z=&roll=&pitch=&yaw=; standing holds the pose (walking starts
    from neutral); PS2 BODY mode on R3 (sticks slide / tilt, L1 / R1 twist, D-pad up /
    down); /status body, bodyK, bodyMode. Compiles, not flashed.
    Controller: BODY in the strip (sticks or W/S A/D R/F Q/E I/K J/L), STOP back to
    neutra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
2026-10-24 Servo Studio: 3D BODY (mithi's IK page, for WHIP): orbit, support polygon, centre of gravity, body sliders / drag, joint table
    WHIP in 3D from his own IK: drag empty space to orbit; the support polygon under the feet that
    are down and his centre of gravity with its balance margin; slide / tilt / twist his body with
    mithi-style sliders or by dragging the body (Shift: tilt, wheel: twist): whip_body.fit_pose,
    the same maths as on him, sets all 18 servos (live when connected); every joint's angle in a
    table. GIFs: the Tripod Forward macro walking in 3D, body posing; stills of every view.
2026-10-24 His web page: WHIP in 3D (plain JS, from /pose), his own colours; fake WHIP serves the page
    /pose: his 18 joint angles and body pose; the page draws him through his own leg geometry
    (the reverse of ik_gait.h solve, as whip_body.joints) from a camera you drag, with the ground,
    the support polygon and his centre over it, five times a second. The page's colours are his
    colour_scheme.xml now (was the old blue fleet HUD). fake_whip.py serves the page straight out
    of esp32_gaits.ino, his avatar and /pose (EMULATE works in a browser too). Compiles, not flashed.
2026-10-24 README + Pages: both avatars, walking / body-IK GIFs, every UI, six gaits, body IK, PS2 pad, studio, voice
    His character avatar and WHIP the machine (images/whip_real.jpg, from realAvatar.jfif) side by
    side; GIFs of his Tripod Forward macro walking in Servo Studio's 3D view and body IK; every UI
    captured on EMULATE (Servo Studio's four views, the controller, his web page); Related hexapods:
    Jakob Leander's (his IK and measurements) and mithi's (the same chassis family; 3D BODY's idea).
2026-10-25 WHIP: customizable lights, red start countdown, PS2 diagnostics
    - leds.h: every look's colour and effect (solid/breathe/blink/rainbow/off) and
    brightness, kept in flash; new looks STARTING (red, filling) and BODY (amber)
    - /leds route and /lights page with colour pickers (PIN-locked like driving)
    - The 5 s before he walks off now counts from the end of setup (it used to run
    out during the ~22 s boot, so he walked at once and never showed red)
    - /ps2 route and a Serial2 diagnosis of the receiver's raw answer;
    PS2_DEBUG_USB copies it to USB serial (only with the servo board off)
    - ps2.h: wire colours
2026-10-25 WHIP: each gait its own leg colour and tune
    - The grid's leg cells take the chosen gait's colour (tripod red, ripple orange,
    wave yellow, quad green, amble cyan, metachronal magenta), changeable on /lights
    - Gait change plays a different tune per gait instead of 1-6 identical beeps
    - PS2_DEBUG_USB switch off by default
2026-10-25 WHIP: leg channel map as he is wired
    Each leg is on the servo board pins nearest it: 1-3 right back, 4-6 right
    middle, 7-9 right front, 24-26 left front, 27-29 left middle, 30-32 left back.
    The defaults had 1-9 as the left legs front to back, so he turned the wrong
    way and the hello wave lifted a back leg. A calibration saved under the old map
    is moved over once (each channel's trim and direction go with it), so there is
    no need to recalibrate. The emulator and Servo Studio follow.
2026-10-25 WHIP: wiring table in the README; Servo Studio's calibration on the new map
    whip_calibration.json moved over by channel (trims and directions kept), so
    Servo Studio's 3D view and the emulated XML show each leg where it really is.
    gait_emulated.xml regenerated: Forward, Crab and Turn decode the right way.
2026-10-25 WHIP: resting stays resting until you drive him
    Standing idle in WEB mode re-applied the body pose every loop; while lying down
    that counted as a move, which got him up, so he lay down and stood up over and
    over. applyBody() now leaves him down. REST during obstacle avoidance switches
    to WEB first, so the walk doesn't get him straight back up.
2026-10-25 WHIP: all six hips reversed in the new leg map
    He walked forward right under the old map but turned the wrong way. Simulating
    both hip directions per side, only one fits that: every hip servo turns the
    other way to the IK, and the old map's front/back mix-up cancelled it for
    walking forward. With the wiring-true map the hips must be reversed, or he'd
    walk backwards. A saved calibration from the old map gets its hips flipped once.
2026-10-25 WHIP: screenshots and studio GIFs on the new leg map
2026-10-25 WHIP: build switch on GPIO 33, every servo to 1500 us
    A toggle switch to GND holds all 18 servos at their plain middle (no trim, no
    direction) so horns go on straight while he's built. On at boot he goes there
    without standing first; off, he stands in WEB mode. Nothing drives him while
    it's on, mid-gait included. /status reports centred.
2026-10-25 WHIP: Servo Studio outranks everything; one setting, everywhere
    Servo Studio holds him over /studio (its session id, a check-in every second,
    5 s quiet and he's his own again): his controller, web page, IR, PS2 pad, MIND
    and tilt safety wait, even from the same PC. Up to four devices unlocked at
    once. /status carries rev, a fingerprint of every saved setting, so his pages,
    the controller and the studio refetch when anything changes. The studio gets
    a calibration panel (trim, rev, wiggle, save on WHIP, defaults), REBOOT WHIP,
    and holds him in SERIAL too while his WiFi answers. The fake matches.
2026-10-25 WHIP TODO: the back legs' slipping, and the flash that should fix it
2026-10-25 WHIP TODO: Brainfuck talk on his buzzer, the LED grid along with it (later)
2026-10-26 WHIP: glide up from 1500 us into the stand (boot, build switch off) instead of one snap
    All 18 servos pulling at once in 300-800 ms made him sag before he stood and walked.
    Now ~2 s, eased in joint angles.
2026-10-26 WHIP: TEST-GAIT, a tripod walk on hips and thighs only
    On the ground every thigh and lower leg is at 0 degrees (1500 us + trim) and the hips sweep
    back to push; a stepping leg lifts on its thigh, the lower leg stays at 1500. Walks and
    turns (no crabbing). /testgait?on=1, a TEST-GAIT button on his page, /status testGait.
    Off at boot; out of it he glides back into the stand.
2026-10-26 WHIP: WEAVE toggle for obstacle mode, his legs stick out past the sonar's cone
    He steers a little left and right as he walks so the beam sweeps, and stops at 48 cm
    (the cone is wider there). Button on his page, /gait?weave=0|1, saved, in /status and rev.
2026-10-26 WHIP: front/back feet 10 mm further out, stride 40 mm: neighbouring legs bumped while walking
    With FB_X 150 and WALK_X 50 the legs on a side came ~68 mm apart (top view,
    centre lines), close enough for the servos and brackets to touch once the
    standing legs give under his weight. FB_X 160 / WALK_X 40 opens that to ~82 mm
    with the same furthest reach (200 mm). gait_test: 0 failures, every gait and height.
    whip_body.py and controller.py follow the new home stance.
2026-10-26 WHIP: ANTI-SLIP toggle, feet planted a moment before the next ones lift
    His feet slipped while the standing legs held him up: in tripod one tripod
    lifted the instant the other landed, so his whole weight swapped onto feet
    still settling. ANTI-SLIP (/gait?antislip=0|1, saved, a button on the page)
    makes every swing PLANT_TICKS (2) moves longer apart: in tripod all six feet
    are down for 2 moves before each lift. Same stride, a 20 -> 24 tick cycle at
    speed 5, so he walks slower. Switching it mid-walk steps to a stop and on
    again, like a gait change. gait_test runs every gait both ways: 0 failures.
2026-10-26 controller_kit.py: the pretend robot takes POSTs, images and streams
    FakeRobot's route() can now answer bytes (an image), a generator (streamed:
    an MJPEG camera) or a content type of its own, and gets POSTs too (q["_body"],
    q["_json"]). KIDA-00's EMULATE needs them; every robot's fake works as before.
    The same file in every controller (fleet TODO section 13).
2026-10-27 WHIP: corner legs point diagonally at 1500 us (MOUNT_DEG), not along the hip's position
    The IK took each leg's 1500 us direction from where its hip sits (atan2 of
    ANCHOR, Jakob Leander's chassis): 27.8 degrees for the corners. WHIP's corner
    legs are mounted at 45. Standing, his corner hips sat ~173 us from 1500 and,
    17 degrees off, his corner feet stood round towards the middle legs, where they
    bumped. MOUNT_DEG (45 / 90 / 135 each side) in ik_gait.h, whip_body.py (Servo
    Studio, the controller) and the web page's 3D view: standing, every hip is now
    within 0.7 degrees (7 us) of 1500. gait_test: 0 failures; compiles.
2026-10-27 flash.ps1: write the parts at their offsets, not the 4 MB merged image
    The merged image fills the whole flash from 0x0, NVS (0x9000) included, so every
    flash blanked WHIP's saved calibration (trims, rev), height, speed, gait, weave
    and anti-slip. Now the bootloader, partition table, boot_app0 and the app go to
    their own offsets from flash_args, and NVS is left alone.
2026-10-27 WHIP: rest belly-down with his legs spread, no folding them up (the death curl)
    restDown() lowered his belly to the floor, then folded every knee and foot 90
    degrees up, one tripod at a time: a tarantula's death curl, which the user
    doesn't want. Now he only lowers his belly, feet where they stand; wakeUp()
    lifts him straight back into the stand. Same for the idle rest, REST and
    shutdown. Compiles.
2026-10-27 WHIP: AUTO-START, FOOT LEAD, JAKOB MOUNT and GAIT PER WALL settings (saved)
    - AUTO-START (off by default): at boot every servo stays at 1500 us in WEB mode
    until the first input (a drive key, a mode, IR, the pad, a body move); then he
    stands up from there. On: stands and walks off in obstacle mode as before.
    - FOOT LEAD 0-9: a stepping leg's foot servo takes its angle from further along
    the swing, so the foot gets there before the thigh. 0 = pure IK.
    - JAKOB MOUNT: corner legs at 1500 us along the hip's position (27.8 deg) instead
    of diagonal (45), to compare on the robot; he re-stands on it.
    - GAIT PER WALL: obstacle mode walks on in the next gait after every wall.
    All on the web p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
2026-10-27 WHIP: Servo Studio follows JAKOB MOUNT; the pretend WHIP takes the gait-row settings
    - whip_body.py: set_mount() switches angles() / joints() between the diagonal
    corners and Jakob's 27.8 deg; Servo Studio sets it from /calib/state
    (jakobMount, now in the firmware's calibState too) whenever his settings move.
    - fake_whip.py: /gait takes weave, antislip, autostart, footlead, jakobmount and
    wallgait, /status reports them and its rev moves with them.
2026-10-28 WHIP: stand 10 mm lower at every height (-80..-160 mm, height 5 = -124)
    The user asked for his body a little lower. REST_Z stays at -75 mm (belly on the
    floor) instead of following height 0. gait_test: 0 failures; compiles.
2026-10-28 WHIP: JAKOB MOUNT on by default (corner legs at 27.8 deg at 1500 us)
    Forward, crab and the dance went wrong after the 45 degree change, so Jakob's
    mount is the default again. A saved 'off' from trying it is turned back on once
    (mountv). The web page, its 3D view, whip_body.py (Servo Studio) and the
    pretend WHIP start with it on. gait_test: 0 failures; compiles.
2026-10-28 WHIP: JAKOB gait (7th): Jakob's own W0-W3 / R0-R3 key frames, as the old sketch walks
    The old sketch walks forward where the engine's tripod steps on the spot; this puts his
    walk in the gaits sketch to compare on the robot. Crabbing has no key frames: the engine
    crabs it as tripod. LEDs use tripod's colour (a new look would reset saved colours).
2026-10-28 WHIP: corner legs fixed at Jakob's 27.8 deg (45 commented out, JAKOB MOUNT toggle gone)
    At 45 every corner foot pushed 17 deg off straight back, front and back ones against each
    other: he swam instead of walking forward. The old sketch (27.8) walks forward.
2026-10-28 WHIP: take the JAKOB gait out again (tripod walks right with the 27.8 deg mount)
    Reverts 6fa1ef1. A saved gait 6 boots as tripod.
2026-10-28 WHIP: Play WHIP, a browser game on his site (play.html)
    His gait engine (gaits.h) and IK (ik_gait.h) ported to JavaScript and drawn in CSS 3D: the same
    stance, stride, lift, six gaits and timing as his ESP32, with hello, dance and rest. Walk, turn
    and crab round an arena collecting orbs (five: he dances); keyboard, a touch pad or a gamepad;
    drag to look round him. Shows the joint pulses his servos would get. play.html#demo walks by
    himself (screenshots).
2026-10-30 WHIP: crab offset, Brainfuck out loud, whip.local
    Crabbing, the back feet land 0-15 degrees in on their hips (saved; 5 to start): the slider on his
    web page and the controller, CRAB - / + on RITA. They're mounted further back to hold his weight.
    /chirp says the fleet's phrases on his buzzer, each symbol on his LED grid, without stopping him.
2026-10-30 WHIP's app: live tiles for his sensors and nearby robots
2026-10-30 WHIP: Obstacle mode in the game, a GIF of it, Servo Studio as an exe
2026-11-04 Bluetooth (fleet_bt), PS2 pad first, smart STAY CLOSE, wifi_rssi
    - esp32_gaits: Bluetooth serial "WHIP" carries his whole web API; his controller's Link: wifi / bluetooth
    - The PS2 pad is his priority controller: /web (but stop) and /mode answer 409 while it drives
    - STAY CLOSE creeps near things and crabs round them (fleet_stay.h, stay_test.cpp)
    - The fleet's WiFi ladder has a RITA rung (between the controllers and NORA): robots join her when she hosts
2026-11-05 Controller exe: close together with the server it started
    The exe and its server live and die together: closing the exe ends the run.bat it started (a job object), and closing the server's window closes the exe.
2026-11-08 Talk switches: TALK SOUND / CHAT on his gaits page
