CursedPrograms/WHIP-Robot-v00/(notices)

Notices in the files:
README.md:
License: MIT
